Murt2005/TPU/rtl/control/activate-engine.sv

`timescale 1ns / 1ps

import tpu_pkg::*;

// ACT engine: ACC rows -> bias -> ReLU/identity -> optional requantize -> UB, host
// out FIFO or DDR3, plus RD_UB and SET_OBASE. to DDR3 the words the host would get
// go to ddr_writer at OBASE, which advances past them; such an ACTIVATE completes
// once the writer has handed every word to the bus. control only: tpu_core wires the bias and activation
// units. shares the ACC and UB read ports with MM, which has priority there; ACT
// has priority on the UB write port
module activate_engine #(
    parameter int ARRAY_SIZE              = 8,
    parameter int UB_ADDRESS_WIDTH        = 14,
    parameter int ACC_ADDRESS_WIDTH       = 10,
    parameter int PARAMETER_ADDRESS_WIDTH = 8
) (
    input  logic                               clk,
    input  logic                               reset,

    input  logic                               queue_valid_in,
    input  logic [QUEUE_ENTRY_WIDTH-1:0]       queue_entry_in,
    output logic                               queue_pop_out,
    input  logic [63:0]                        completed_in,
    output logic                               instruction_done_out,

    output logic [ACC_ADDRESS_WIDTH-1:0]       ACC_read_address_out,
    input  logic                               ACC_read_blocked_in,        // MM owns the port this cycle

    output logic [PARAMETER_ADDRESS_WIDTH-1:0] parameter_read_address_out, // the bias and quant tables
    output logic                               bias_enable_out,            // bias unit
    output logic                               relu_enable_out,            // activation unit
    input  logic [ARRAY_SIZE*32-1:0]           activation_row_in,          //   biased, ReLU'd: stage 1
    output logic                               multiply_enable_out,        //   stage 2 multiplies row
    output logic [ARRAY_SIZE*32-1:0]           multiply_row_out,
    input  logic [ARRAY_SIZE*8-1:0]            quantized_row_in,           //   stage 3

    output logic                               UB_write_enable_out,
    output logic [UB_ADDRESS_WIDTH-1:0]        UB_write_address_out,
    output logic [ARRAY_SIZE*8-1:0]            UB_write_data_out,

    output logic                               UB_read_enable_out,
    output logic [UB_ADDRESS_WIDTH-1:0]        UB_read_address_out,
    input  logic                               UB_read_blocked_in,
    input  logic [ARRAY_SIZE*8-1:0]            UB_read_data_in,

    output logic                               output_push_out,
    output logic [31:0]                        output_word_out,
    input  logic                               output_full_in,

    output logic                               DDR_word_valid_out,         // ddr_writer
    output logic [31:0]                        DDR_word_address_out,
    input  logic                               DDR_full_in,
    input  logic                               DDR_idle_in,

    output logic                               blocked_out,                // has work it can't advance (profiler)
    output logic                               idle_out
);

    localparam int WORDS_PER_INT8_ROW = ARRAY_SIZE / 4;

    logic [63:0] instruction, wait_snapshot;
    assign instruction   = queue_entry_in[63:0];
    assign wait_snapshot = queue_entry_in[127:64];
    logic [5:0] opcode;
    assign opcode = instruction[63:58];

    typedef enum logic [2:0] {S_IDLE, S_READ, S_LATCH, S_MULTIPLY, S_ROUND, S_EMIT, S_WRITE, S_DRAIN} state_t;
    state_t state;

    logic                     is_read_UB;
    logic                     requantize, destination_is_UB, destination_is_DDR;
    logic [31:0]              output_base;                   // OBASE
    logic [15:0]              UB_destination_address;
    logic [8:0]               activation_rows;
    logic [10:0]              block_count, block_index;
    logic [8:0]               row_in_block;
    logic [15:0]              read_address;                  // ACC row, or UB entry for RD_UB
    logic [15:0]              UB_entries_left;               // RD_UB entries
    logic [7:0]               parameter_index;
    logic [7:0]               word_index;                    // word within the row being emitted
    logic [ARRAY_SIZE*32-1:0] result_row;                    // computed row, one word per column (or packed int8)

    assign ACC_read_address_out       = ACC_ADDRESS_WIDTH'(read_address);
    assign UB_read_address_out        = UB_ADDRESS_WIDTH'(read_address);
    assign parameter_read_address_out = PARAMETER_ADDRESS_WIDTH'(parameter_index);
    assign UB_read_enable_out         = state == S_READ && is_read_UB && !UB_read_blocked_in;
    assign multiply_enable_out        = state == S_MULTIPLY;
    assign multiply_row_out           = result_row;

    logic [7:0] words_to_emit;
    assign words_to_emit = (is_read_UB || requantize) ? 8'(WORDS_PER_INT8_ROW) : 8'(ARRAY_SIZE);

    assign UB_write_enable_out  = state == S_WRITE;
    assign UB_write_address_out = UB_ADDRESS_WIDTH'(UB_destination_address);
    assign UB_write_data_out    = result_row[ARRAY_SIZE*8-1:0];
    assign output_push_out      = state == S_EMIT && !destination_is_DDR && !output_full_in;
    assign output_word_out      = result_row[32*word_index +: 32];
    assign DDR_word_valid_out   = state == S_EMIT && destination_is_DDR && !DDR_full_in;
    assign DDR_word_address_out = output_base;

    logic word_emitted;
    assign word_emitted = output_push_out || DDR_word_valid_out;

    logic wait_satisfied;
    assign wait_satisfied = wait_counts_reached(instruction[51:48], wait_snapshot, completed_in);
    assign queue_pop_out  = queue_valid_in && state == S_IDLE && (opcode != OPCODE_WAIT || wait_satisfied);
    assign idle_out       = state == S_IDLE && !queue_valid_in;
    // a WAIT not yet satisfied, MM holding the ACC or UB read port, a full out FIFO or DDR3 writer
    assign blocked_out    = (queue_valid_in && state == S_IDLE && !queue_pop_out)
                            || (state == S_READ && (is_read_UB ? UB_read_blocked_in : ACC_read_blocked_in))
                            || (state == S_EMIT && !word_emitted) || (state == S_DRAIN && !DDR_idle_in);

    always_ff @(posedge clk) begin
        if (reset) begin
            state                  <= S_IDLE;
            is_read_UB             <= 1'b0;
            relu_enable_out        <= 1'b0;
            bias_enable_out        <= 1'b0;
            activation_rows        <= '0;
            block_count            <= '0;
            block_index            <= '0;
            row_in_block           <= '0;
            read_address           <= '0;
            UB_entries_left        <= '0;
            parameter_index        <= '0;
            word_index             <= '0;
            result_row             <= '0;
            requantize             <= 1'b0;
            destination_is_UB      <= 1'b0;
            destination_is_DDR     <= 1'b0;
            output_base            <= '0;
            UB_destination_address <= '0;
            instruction_done_out   <= 1'b0;
        end else begin
            instruction_done_out <= 1'b0;
            case (state)
                S_IDLE: if (queue_pop_out) begin
                    if (opcode == OPCODE_ACTIVATE) begin
                        is_read_UB             <= 1'b0;
                        requantize             <= instruction[55];
                        destination_is_UB      <= instruction[54:53] == DESTINATION_UB;
                        destination_is_DDR     <= instruction[54:53] == DESTINATION_DDR;
                        UB_destination_address <= 16'(instruction[23:10]);
                        relu_enable_out        <= instruction[57:56] == 2'd1;
                        bias_enable_out        <= instruction[52];
                        block_count            <= 11'(instruction[51:42]) + 11'd1;
                        activation_rows        <= 9'(instruction[41:34]) + 9'd1;
                        read_address           <= 16'(instruction[33:24]);
                        parameter_index        <= instruction[9:2];
                        block_index            <= '0;
                        row_in_block           <= '0;
                        state                  <= S_READ;
                    end else if (opcode == OPCODE_RD_UB) begin
                        is_read_UB        <= 1'b1;
                        requantize        <= 1'b0;
                        destination_is_UB <= 1'b0;
                        destination_is_DDR <= 1'b0;
                        read_address      <= 16'(instruction[45:32]);
                        UB_entries_left   <= 16'(instruction[11:0]) + 16'd1;
                        state             <= S_READ;
                    end else begin
                        if (opcode == OPCODE_SET_OBASE)
                            output_base <= instruction[31:0];
                        instruction_done_out <= 1'b1;            // SET_OBASE, WAIT
                    end
                end
                S_READ: if (is_read_UB ? !UB_read_blocked_in : !ACC_read_blocked_in) state <= S_LATCH;
                S_LATCH: begin                         // read data valid this cycle
                    result_row <= is_read_UB ? (ARRAY_SIZE*32)'(UB_read_data_in) : activation_row_in;
                    word_index <= '0;
                    state      <= requantize ? S_MULTIPLY : destination_is_UB ? S_WRITE : S_EMIT;
                end
                S_MULTIPLY: state <= S_ROUND;                 // the activation unit multiplies row
                S_ROUND: begin
                    result_row <= (ARRAY_SIZE*32)'(quantized_row_in);
                    state      <= destination_is_UB ? S_WRITE : S_EMIT;
                end
                S_WRITE: begin                         // one UB entry per row
                    UB_destination_address <= UB_destination_address + 16'd1;
                    read_address           <= read_address + 16'd1;
                    state                  <= S_READ;
                    if (row_in_block == activation_rows - 9'd1) begin
                        row_in_block    <= '0;
                        parameter_index <= parameter_index + 8'd1;
                        if (block_index == block_count - 11'd1) begin
                            state                <= S_IDLE;
                            instruction_done_out <= 1'b1;
                        end
                        block_index <= block_index + 11'd1;
                    end else begin
                        row_in_block <= row_in_block + 9'd1;
                    end
                end
                S_EMIT: if (word_emitted) begin
                    if (destination_is_DDR)
                        output_base <= output_base + 32'd4;
                    if (word_index == words_to_emit - 8'd1) begin
                        read_address <= read_address + 16'd1;
                        state        <= S_READ;
                        if (is_read_UB) begin
                            UB_entries_left <= UB_entries_left - 16'd1;
                            if (UB_entries_left == 16'd1) begin
                                state                <= S_IDLE;
                                instruction_done_out <= 1'b1;
                            end
                        end else if (row_in_block == activation_rows - 9'd1) begin
                            row_in_block    <= '0;
                            parameter_index <= parameter_index + 8'd1;
                            if (block_index == block_count - 11'd1) begin
                                if (destination_is_DDR) begin
                                    state <= S_DRAIN;
                                end else begin
                                    state                <= S_IDLE;
                                    instruction_done_out <= 1'b1;
                                end
                            end
                            block_index <= block_index + 11'd1;
                        end else begin
                            row_in_block <= row_in_block + 9'd1;
                        end
                    end else begin
                        word_index <= word_index + 8'd1;
                    end
                end
                S_DRAIN: if (DDR_idle_in) begin                // every word is on the bus
                    state                <= S_IDLE;
                    instruction_done_out <= 1'b1;
                end
                default: state <= S_IDLE;
            endcase
        end
    end

endmodule
