Murt2005/TPU/(commit log)

2026-06-19 fixed syntax in mmu and logic in pe
    [mmu.sv, pe.sv]
2026-06-19 fixed syntax in mmu.sv and logic in pe.sv
    [mmu.sv, pe.sv]
2026-06-27 Add weight loader (ROM -> weight_fifo bridge)
    Reads a weight tile from a dual-port weight ROM and pushes it into the
    weight_fifo shadow bank in bottom-row-first order per the staggered
    weight-load contract. Dual read ports fetch a full row per cycle so both
    columns push together; ROM_LATENCY parameter keeps the FSM correct for
    combinational, output-registered, or fully-registered (M10K, 2-cycle) ROMs.
    done pulses one cycle after the final FIFO write so the sequencer can swap
    banks safely.
    Adds self-checking weight_loader_tb (registered 2-cycle ROM model) and
    weight_loader_fifo_tb (ROM -> loader -> weight_fifo -> drain) integration
    test. Wires both into the Makefile and run_tests.sh (15 test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
2026-06-30 added uart rx/tx
2026-07-05 Add pico2-ice (iCE40) build target; fix yosys/iverilog portability issues
    yosys's built-in SystemVerilog frontend can't parse unpacked-array module
    ports (used throughout the datapath for 2-wide buses) or SVA immediate
    assertions with an else clause. Converts those ports to packed 2D arrays
    and rewrites fifo.sv's depth check as a plain if/$fatal, so the design
    now synthesizes for iCE40 as well as Cyclone V.
    The packed-array conversion also surfaced two latent Icarus Verilog 13.0
    quirks: a word-select out of a signed packed 2D array silently drops its
    signedness (activation.sv's ReLU check now uses an explicit $signed()
    cast), and a same-time-step testbench read of a combinational output can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
    [accumulator.sv, activation.sv, bias.sv, fifo.sv]
2026-07-06 Bring up tpu_top on real pico2-ice hardware; add tpu_host.py
    Full datapath now verified end-to-end on real iCE40 silicon, matching
    simulation golden values bit-for-bit.
    Two real bugs found and fixed along the way:
    - tpu_top.sv had no power-on-reset generator. Every module's registers
    (e.g. uart_tx's tx_busy/state) only get a known-good value inside their
    `if (reset)` branch. On this board reset_n reads idle-high the instant
    the FPGA configures (a plain pull-up, no reset IC), so that branch never
    fired even once, leaving registers to whatever the toolchain's power-on
    initial-value inference happened to pick -- uart_tx powered up
    permanently stuck (tx_busy never clear) and never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
2026-07-06 Add pico2-ice bring-up runbook; fix unused-var lint in tpu_host.py
    Documents the full build/flash/validate process end to end, plus the
    real bugs found during hardware bring-up (wrong RP2350 UART pins, the
    DFU false-alarm status message, and the missing power-on-reset that
    left uart_tx stuck) so the next person debugging this doesn't have to
    re-derive it from scratch.
2026-07-07 added pico-ice-sdk as a submodule under firmware/
2026-07-07 Add LED green/blue command listener to RP2040-logs CDC port
2026-07-07 Add multi-layer MNIST inference driver and interactive drawing demo
2026-07-11 added CMD_RUN_TILE
    cut ms/image from ~8000 to ~4000
2026-07-12 raise UART to 1 Mbaud (Tier 1): 2454 -> 316 ms/image on MNIST
    BAUD_RATE is now an fpga/Makefile build knob baked into the bitstream (1 Mbaud = exact /12 of the 12 MHz clock, zero baud error), with tpu_host.py defaulting to match.
2026-07-12 fix TinyUSB race in uart0->CDC bridge: ring buffer instead of ISR writes
    The UART0 RX ISR wrote to TinyUSB concurrently with the main loop's tud_task(), wedging the whole USB stack at 1 Mbaud; the ISR now only fills a ring buffer that the main loop drains.
2026-07-12 scale array to 2x4 (8 PEs, all DSP-backed): 316 -> 240 ms/image on MNIST
    4x4 doesn't fit the UP5K and 2x4 beats 4x2 since wire bytes scale as K*N*M_TILE/NUM_COLS; the shape is now a Makefile build knob, and the host zero-pads any M/K/N so odd shapes just work.
2026-07-12 probe array shape + resync sequencer on connect
    TPU() now flushes any pending frame, resets, and probes the device's synthesis-time shape, so a host/bitstream mismatch fails immediately with a message naming the --rows/--cols/--m-tile fix instead of silently desyncing the sequencer.
2026-07-12 fix all verilator lint warnings in RTL: dead result_ok, width casts, genvar shadowing, generate labels
    [accumulator.sv, fifo.sv]
2026-07-12 add make lint + Verilator C++ full-chip testbench (make verilate-test, 3 shapes over real UART pins)
2026-07-12 add SPI host PHY: spi_slave.sv + USE_SPI build knob + CMD_NOP poll filler, verified in sim (unit TB + full-chip Verilator SPI BFM)
2026-07-12 add TPU_LINK_SPI firmware bridge: CDC<->spi0 with frame-aware response polling, flash deep-power-down on the shared bus
2026-07-13 SPI link bring-up: --link spi host flag (no write pacing, SPI wire accounting), 24 MHz FPGA clock for SPI builds: 239 -> 88 ms/image on MNIST
2026-07-13 add FW_MATMUL bulk command to run the whole tiling loop on the RP2350 (firmware/tpu_tile.c absorbs the SPI bridge), host probe + offload path with --no-offload fallback, offload-vs-local A/B in hw_re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
2026-07-24 extract wire-protocol opcodes/status into rtl/tpu_pkg.sv, imported by the sequencer
2026-07-24 restructure fpga/ into per-board dirs (fpga/ice40) with a board dispatcher; update README paths
2026-07-24 add DE1-SoC HPS transport: extract board-neutral tpu_core, add hps_bridge Avalon-MM PHY + tpu_top_hps + unit tb
2026-07-24 README: expand DE1-SoC future work with the AWS cloud-build infra and on-board bring-up / scale-up next steps
2026-07-30 docs: rewrite as a 10-file set organized around the current architecture
    The old docs/ was a chronological analysis trail: proposals for work that
    shipped weeks ago, headline numbers from the 2x2/UART era, and two array-size
    ceilings that were later retracted. Rewritten around what the design is now
    rather than how it got here, with the measurement history consolidated into
    one dated section of performance.md.
    README.md index + reading order
    architecture.md datapath, board-neutral core vs tops, shape parameters
    protocol.md wire protocol as shipped, all three PHYs, FW_* commands
    pico2-ice.md iCE40 target reference: knobs, gotchas, bisect ladder
    de1soc.md Cyc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
2026-07-30 README: correct the retracted 4x4 ceiling and other claims stale since 07-13
    - The 'largest shape that fits' bullet still said 2x4, and cited the 8-DSP
    ceiling that pe_pair.sv's dual-8x8 SB_MAC16 mode retired. It's 4x4/M_TILE=4
    at 4,935 LCs (93%), hardware-validated 14/14.
    - hw-test validated shapes: add 4x4.
    - Fastest config (§5.1) rebuilt around the 4x4 SPI build; add the
    USE_MAC16_PAIR build knob, which was undocumented.
    - Latency: six steps -> seven (the pe_pair array), 64 -> 63.8 ms.
    - verilate-test covers seven shape/PHY combos, not three.
    - Point at docs/ from the intro, §5.2 and the future-work bullet.
2026-07-30 add CLAUDE.md steering files (root + 4 nested)
    Root: two-chip model and the firmware-first flash order, the make targets,
    the four gotchas that cost the most time (dfu-util's false "firmware
    corrupt", the CLK_FREQ/baud coupling across three files, the post-flash
    replug, the indistinguishable CDC ports), layout, and status pointing at
    README §6 rather than duplicating it. Pulls in docs/ via @imports.
    Nested, so each only loads when work is actually in that directory:
    rtl/ house style, the ARRAY_ROWS/NUM_COLS/M_TILE pattern, and that
    module latency is a contract the sequencer replays exactly
    firmware/ cmake knobs, the vendored SDK submodule and its two worked-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
2026-09-21 pe/mmu: make the partial-sum width a parameter
    pe.sv hard-wired its psum ports to [15:0]. Add PSUM_WIDTH (default 16, so
    every existing build is unchanged) and thread it from mmu.
    The MAC's zero addend becomes a signed localparam rather than a bare '0:
    an unsigned literal there would make the whole addition unsigned and
    silently break sign extension of the product.
    pe_pair is SB_MAC16-backed and its accumulator is a hard 16 bits, so the
    DSP-pair path now $errors unless PSUM_WIDTH=16, alongside the existing
    even-ARRAY_ROWS check.
    [mmu.sv, pe.sv]
2026-09-21 sequencer/core/tops: thread PSUM_WIDTH as a build knob
    Widening the reduction path is a wire-format change, not just a datapath
    one: bias and result elements become PSUM_WIDTH/8 little-endian bytes
    each. Both pack/unpack loops now iterate PSUM_BYTES instead of assuming
    2, and B_BYTES/RESULT_BYTES derive from it.
    Default stays 16, so every existing bitstream, host and test vector is
    byte-identical -- verified with make test (22/22), make lint (4 configs)
    and make verilate-test (7 shape/PHY combos), all unchanged.
    Adds elaboration guards for the constraints a wide build can trip: LEN is
    one byte, so PSUM_BYTES*M_TILE*NUM_COLS must stay under 256. At 32 bits
    that caps M_TILE*NUM_COLS at 63 --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
2026-09-21 activation: make the ReLU clamp bypassable per RUN
    activation.sv applied ReLU unconditionally with no bypass mode, so every
    layer had to be ReLU-terminated. Any network with a linear output
    projection was unrepresentable.
    Adds a `bypass` input, selected per pass by flags[2] of the RUN /
    RUN_TILE / STREAM_RUN flags byte and held stable by the sequencer for the
    whole orchestration sequence, exactly like tile_first/tile_last. Latency
    is unchanged in both modes, so the sequencer's replayed cycle sequence
    does not move.
    The flags-byte bit positions now have names in tpu_pkg alongside the
    opcodes, replacing the bare payload[0][0]/[1] literals at the three
    parse sites.
    Default is 0, so an existi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
2026-09-21 tpu_host: psum_width and act_bypass support
    Mirrors the RTL side. psum_width (default 16) drives the bias/result
    element dtype and result_bytes; act_bypass sets the new flags[2] on RUN,
    RUN_TILE and STREAM_RUN. The flags byte is packed by one _flags() helper
    instead of three copies of the same bit arithmetic, with FLAG_* constants
    mirroring tpu_pkg.
    FW_MATMUL is compiled into the firmware with a 16-bit result element and
    no flags plumbing, so matmul_tiled falls back to the host-tiled path when
    psum_width != 16 or act_bypass is set, and offload=True now raises rather
    than silently returning ReLU'd or wrong-width results.
    The shape-probe mismatch error names psum_width too -- the probe compa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
2026-09-21 verilate-test: cover PSUM_WIDTH=32 and the ReLU bypass
    The C++ bench assumed int16 in four places (RESULT_BYTES, the golden
    model's wrap, the bias pack and the result unpack). All four now derive
    from TB_PSUM_WIDTH, and golden() takes a relu flag so it can model the
    bypass path.
    Three new shapes, selected by a trailing 32 on the PHY field:
    2_2_2_uart32, 4_4_2_spi32, 8_8_4_uart32. The last is the transformer-
    sized one -- M_TILE=4 rather than 8 keeps the result frame at 128 bytes,
    since 8x8/M_TILE=8 at 4 bytes per element would need 256 and blow the
    1-byte LEN cap.
    Three new cases: ACT_BYPASS over bare RUN (asserting negatives actually
    survive, so the test cannot pass vacuously), ACT_BYPASS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
2026-09-21 docs: PSUM_WIDTH build knob and the ReLU bypass flag
    Documents both features and adds PSUM_WIDTH to fpga/ice40/Makefile's
    chparam list so it is a real build knob rather than an RTL-only
    parameter.
    Deliberately does not touch any measured result in performance.md: no
    bitstream has been built at PSUM_WIDTH != 16, so the LC/fMax/latency
    tables still describe exactly what they describe. The docs say so
    explicitly -- the wide path is simulation-only coverage.
    Measured cost of the bypass on the tightest build (4x4/M_TILE=4, SPI,
    MAC16 pair), against a baseline worktree on the same toolchain:
    4958 -> 4999 LCs (93% -> 94%), core fMax 32.30 -> 30.08 MHz. Still
    places, routes and passes at the 24 MH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
2026-09-21 verilate-test: direct byte-stream injection bench
    Adds a third transport alongside the UART and SPI BFMs. TB_DIRECT
    verilates tpu_core rather than tpu_top and drives the sequencer's
    rx_data/rx_valid directly, skipping the bit-level PHY. Same protocol,
    same golden checks, same test list.
    40x fewer cycles per tile at 8x8 (288 vs 11520), which is what makes
    transformer-sized workloads tractable in simulation: the whole suite
    runs in 271k cycles against 11.1M over UART at that shape.
    Two pacing constants, both needed because there is no PHY cadence and
    the sequencer exposes no backpressure:
    STREAM_TILE_GAP covers the pipeline pass the sequencer spends between
    tiles not consuming RX. Model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
2026-09-21 sim link: drive the Verilator model from tpu_host.py
    Adds `--link sim`, a third transport beside uart/spi/hps. The direct
    bench gains a --bridge mode that reads host->FPGA frames on stdin and
    writes responses on stdout; SimLink spawns it and presents the same
    duck-typed serial.Serial surface MmioLink already does. `make sim-bridge`
    builds the binary at any shape.
    Everything above the transport is now shared between simulation and
    silicon: matmul_tiled's zero-padding, K-tiling and STREAM_RUN chaining
    run unchanged, so a model debugged in sim moves to the board by changing
    one flag.
    tests/hw_regression.py gains --link sim and --psum-width, and its golden
    model is no longer hardcoded to int16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
2026-09-21 llm: run TinyStories-1M on the array
    A GPT-Neo forward pass whose six linear layers per block, plus the tied
    lm_head, execute as int8 matmuls on the TPU. Host keeps what the hardware
    has no unit for: embedding lookup, LayerNorm, softmax, GELU, residuals.
    Quantization is post-training with no calibration set. Weights are int8
    with a per-output-channel scale (0.39% worst relative error on this
    checkpoint); activations are quantized dynamically per matmul from their
    own max, which is what removes the calibration requirement. Bias stays
    float and is added after dequantization -- folding it into the
    accumulator would need the activation scale, which only exists at
    runtime.
    Needs PSUM_WIDTH=32: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
2026-09-21 viz: RTL trace harness, extractor, and a validated JS datapath model
    Groundwork for an interactive datapath visualizer. Three pieces, each
    independently checkable.
    trace_tb.cpp verilates tpu_core with --trace and drives one RUN_TILE over
    the real byte protocol, dumping every internal signal and echoing the
    device's result. No RTL changes: a VCD already records more than any
    amount of $display would, and synthesizable code stays clean.
    vcd_to_trace.py samples that VCD once per rising edge into a per-cycle
    JSON timeline -- a frame sequence rather than a change log -- keeping the
    ~120 signals the viewer draws, including every PE's weight_reg, streaming
    activation and partial sum.
    model.mjs i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
2026-09-21 viz: interactive datapath viewer
    An HTML page that runs model.mjs in the browser: type in W, A and bias,
    then scrub or play the clock and watch activations sweep right while
    partial sums fall. Colour encodes the three data roles rather than
    decorating -- violet for the stationary weight, amber for an activation
    in flight, teal for a partial sum -- so the wavefront reads at a glance.
    Published at https://claude.ai/artifact/Sr4fZ6oUw15Ee8fXSCq5dC, with
    model.mjs served alongside it from this same file so the page and the
    repo cannot drift apart.
    The page opens mid-wavefront on a worked example rather than empty, and
    checks the rows the ReLU stage actually emitted against a reference so
    the a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
2026-09-21 Makefile: restore the viz targets to .PHONY after the merge
    Both branches edited the same .PHONY line, and the auto-merge kept only
    sim-bridge -- sim-trace, viz-check and viz-check-all were silently
    dropped, so a stray file of any of those names would have shadowed them.
2026-09-21 docs: utilization analysis and a command-interface design
    Measures what the array actually does with its cycles (7-16% MAC-slot
    utilization) and what the wire actually carries, then works out what
    follows.
    Two findings worth the doc. weight_fifo's ping-pong banks are built and
    tied off in tpu_core, and because the sequencer serializes receive and
    compute it stops consuming RX between tiles -- which is the sole reason
    the SPI write clock is capped at CLK/6. One change lifts both ceilings.
    backlog.md's 'worth ~2ms at most' predates this and misses the coupling.
    And weight residency alone is only 2.7x on MNIST, not the order of
    magnitude it looks like, because padded activations then dominate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
2026-09-29 docs: expand architecture.md into a whole-system reference
    Covers the sequencer FSM, PHYs, numerics, the software stack, and the
    build flow; corrects 2x2-only latencies to R+C+3 and notes the RTL
    capabilities tpu_core leaves unwired. Section refs updated to match.
2026-09-29 docs: bring the rest of the docs in line with the September work
    ReLU bypass, PSUM_WIDTH, the sim link, llm/ and viz/ were missing or
    contradicted across README, CONTRIBUTING, CLAUDE.md files, docs/, and the
    firmware/DE1-SoC READMEs. Also corrects claims that never matched the
    code: --link hps in hw_regression/infer, --timing-breakdown, on-chip
    layer write-back, 3-step testbench registration, widths in tpu_pkg.
    [accumulator.sv]
2026-09-30 remove viz/: the datapath visualizer, its trace harness, and make targets
2026-09-30 remove the CLAUDE.md steering files
2026-09-30 restructure: rtl/{core,peripherals}, boards/<board>/, tests by tier, software/
    Board-specific files (tops, pe_pair, pins, FPGA build, firmware) move
    under boards/pico2-ice and boards/de1soc; rtl/ keeps only what every
    board shares. Tests split into sv/, verilator/, hw/; mnist and llm move
    to software/; the Makefile's rules split into mk/. The fpga/ dispatcher
    is gone. Both bitstreams (2x2 UART, 4x4 SPI pair) rebuild bit-identical.
2026-09-30 host: turn tpu_host.py into the host/tpu package with one golden model
    protocol / links / driver / golden / cli modules, installable via
    requirements.txt. The four copies of the reference numerics
    (hw_regression, train_mnist, llm, selftest) now share tpu.golden, and
    the sys.path edits are gone. tpu_host.py stays as a thin wrapper.
2026-09-30 add make check-protocol: the four copies of the wire constants must agree
    RTL package, host driver, C++ bench, and firmware each define the
    opcodes/flags/status bytes; nothing generated one from another. Runs as
    part of make lint. Adds CMD_NOP to the host copy so it mirrors all of
    tpu_pkg.
2026-09-30 boards/pico2-ice: named build configs (make CONFIG=4x4_spi)
    One .mk per hardware-validated build, loaded by both the FPGA build and
    make hw-test, plus make host-flags / show-config for the matching host
    flags. The bitstream now depends on a stamp of every knob, so switching
    config rebuilds instead of reusing the previous config's tpu_top.bin.
2026-10-01 trim comments to short lowercase decision notes; explanations live in docs/
    Header blocks, restated code and narrative history removed across rtl,
    boards, firmware, host, software, tests and build files; what remains
    marks decisions and low-level traps. Code is unchanged (verified with
    comments stripped, and both reference bitstreams match HEAD). protocol.md
    is now the normative protocol spec, and CONTRIBUTING states the rule.
    [accumulator.sv, activation.sv, bias.sv, fifo.sv, golden.py, mmu.sv]
2026-10-01 isa: encoder, reference model and layout helpers for the instruction-stream core
    Phase 1 groundwork from the DE1-SoC instruction stream spec. One field
    table drives encode/decode/reserved-bit checks and reproduces all 16
    encodings in the spec's worked MNIST program. The model executes
    programs in order with 32-bit wrap and the decode errors; it matches
    tpu.golden on random layers and hw_layer on MNIST layer 1.
    [isa.py, isa_layout.py, isa_model.py]
2026-10-01 isa: phase 2 - requantizer and on-chip layer chaining
    ACT requantizes (27-bit pre-saturation, 24-bit M0, round half up, int8
    clamp) and writes the UB, with priority over LD on the write port.
    compile_mlp emits the spec's load/infer programs. Verified: 1.06M inputs
    per (M0, shift) table incl. per-channel match the model; the full
    two-layer MNIST program runs on chip, RTL == model word for word, argmax
    == the host path on 20 images at m=1 and m=8.
2026-10-01 isa: phase 3 - overlapped tiles, verified in Verilator sim
    new isa_pe (w_cur/w_next, flipped by the tile's first activation) and
    isa_array with a per-column skewed row-select weight bus; WT gets a
    two-slot tile buffer that refills a slot the cycle MM releases it; MM
    streams one tile per max(m, N) cycles while loading the next tile's
    weights. isa_waits models per-engine read/write sets and inserts WAITs.
    sim only, no board: RTL == model on 400 random concurrent programs at
    N=8 and N=4 (39/40 diverge without their WAITs), PE invariants never
    fire, T extra tiles cost exactly T*max(m, N) cycles with no extra
    WSTALL at m=1, m=N, m>N. make lint and make test green.
    [isa_compile.py, isa_mm.sv, isa_waits.py, isa_wt.sv]
2026-10-01 de1soc: FPGA-only self-test for the instruction-stream core
    isa_replay plays a ROM register transcript (every expected word from the
    reference model) into tpu_isa_top and reports on LEDR/HEX, so the
    netlist can be checked with no HPS, Linux or SD card. Standalone
    Quartus project with pins cross-checked against a published DE1-SoC
    qsf. IsaModel.run now returns only the words a run produced, as a host
    draining the out FIFO sees them.
    Verilator sim only: PASS at N=8 and N=4; an injected wrong word fails
    with the right mark and count; an empty ROM fails instead of hanging.
    Not yet compiled in Quartus or run on the board.
    [isa_model.py, isa_replay.sv, tpu_isa_selftest.sv]
2026-10-01 de1soc: instruction-stream core passes its self-test on the board
    first hardware result for rtl/isa. fixes the Quartus build needed:
    - multiplies at their real widths: the requantizer was 64x64 per lane
    and the tile/range products 32/64-bit, 120 DSPs on an 87-DSP part; now 78
    - requantizer pipelined over three ACT states: in one cycle it missed
    50 MHz by 4 ns; now Fmax 57.9 MHz in the slow corner
    - single-threaded Quartus: its parallel helpers deadlock under Rosetta
    hardware: self-test PASS on the DE1-SoC (N=8, 50 MHz). sim: isa-test
    (265K requant inputs per table), self-test sim, make lint, make test green.
    [isa_act.sv, isa_dispatch.sv, isa_mm.sv, isa_wt.sv]
2026-10-01 gitignore: quartus pin model dump
2026-10-01 de1soc: perf counters on the self-test, tile rate checked on the board
    isa_replay gets CAP (register -> one of 32 slots) and CHECK (bound a
    slot or a difference, on chip); SW9 + SW4..0 show a slot on HEX5..0.
    the ROM runs 8 vs 16 tiles at m=1, 8, 19 and requires exactly
    8*max(m, 8) extra cycles with no extra WSTALL, and captures the MNIST run.
    hardware: PASS on the DE1-SoC, and every captured slot read off the
    displays equals the Verilator run.
2026-10-01 de1soc: TPU on the HPS bridge, full test suite passes on the board
    tpu_isa_top as a Platform Designer component in Terasic's rev H GHRD at
    0xFF200000 (h2f_lw, clk_0); the Makefile extracts the GHRD from the CD
    and applies the edit, so only our files are tracked. isa_mmio is an ARM
    /dev/mem register server speaking tb_isa's protocol; IsaSerialLink runs
    it over the HPS console, so test_isa_rtl.py drives the board unchanged.
    hardware: U-Boot loads the bitstream from SD, timing met at 50 MHz,
    and every functional test passes on the board: decode errors, 40 random
    layers, MNIST layer 1 and the chained two-layer program, requantizer
    sweeps, 40 random concurrent programs. the cycle-rate check now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
    [isa_device.py]
2026-10-01 de1soc: MNIST end to end on the ARM + TPU, drawing demo on the HEX displays
    mnist_tpu runs on the HPS: raw pixels -> downsample/quantize (bit-exact
    with numpy) -> both layers on the TPU over the lightweight bridge ->
    argmax. bench mode covers the test set; serve mode backs
    draw_demo.py --de1soc, which shows the digit on HEX0 through a new
    hex_pio (0xFF210100) decoded by top/hex_display.sv. the same C builds
    with -DSIM against Verilator. BoardConsole is the shared console launcher.
    hardware, 10,000 test images: 97.50%, 10,000/10,000 equal to the
    reference model; 109.5 us/image end to end at m=1, 77.6 us at m=8.
2026-10-01 de1soc: drawing demo over the console at 1.5625 Mbaud; upload without the SD card
    draw_demo.py --de1soc PORT --baud 1562500: mnist_tpu serve switches the
    HPS console for the session via termios2/BOTHER and restores 115200 on
    exit. 1562500 = 6.25 MHz / 4 is the fastest rate the HPS UART and the
    CP2105 both produce (2083333 doesn't link; busybox stty stops at 921600,
    hence setbaud, a 636-byte libc-free helper). BoardConsole gains stuck-
    console recovery and upload(): raw tty + dd bs=1, md5-checked .part.
    hardware: 10/10 test images correct at both rates; round trip from the
    Mac 73.5 ms -> 7.5 ms, 117 us on the board; 379 KB upload md5-verified.
    [isa_device.py, setbaud.c]
2026-10-01 docs: bring every README and doc up to the DE1-SoC state
    new docs/isa.md: the instruction-stream core's reference (ISA and
    fields, engines, WAIT/SIGNAL, decode errors, layouts, the isa_bridge
    register map, requantizer, overlap, compiler, verification). rewritten:
    docs/de1soc.md (what runs on the board, rev H, the OrbStack Quartus
    toolchain, both build flows, the gotchas), the root README (DE1-SoC
    quick start first; pico2-ice kept as §2), the docs index, verification,
    performance (DE1-SoC numbers), backlog, repo map, the DE1-SoC FPGA
    README. the legacy pages say which core they describe. fixes a stale
    ./llm/fetch.sh path; hps make all also builds setbaud.
2026-10-01 core: move the instruction-stream core into rtl/core, on the TPUv1 datapath files
    rtl/isa/ is gone. its datapath now lives in the original module files,
    rewritten for the new ISA: pe (w_cur/w_next + flip), mmu (row-select
    weight bus), weight_fifo (the two-slot tile buffer), accumulator (column
    de-skew, row tags, the ACC memory and its read-modify-write), bias,
    activation (ReLU + the 3-stage requantizer), unified_buffer, with
    fifo and systolic_data_setup unchanged. tpu_core wires them around the
    control: dispatch + ld/wt/mm/act_engine. isa_ prefix dropped: tpu_pkg,
    host_bridge, tpu_top, tpu_selftest, replay; the Quartus projects follow.
    legacy pieces this makes unbuildable go with it: tpu_se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
    [accumulator.sv, activation.sv, bias.sv, dispatch.sv, mmu.sv, pe.sv, replay.sv]
2026-10-01 tests: unit benches for the rewritten core modules
    plain SystemVerilog, run by verilator --binary (make unit, make
    unit-<name>): a shared check.svh gives named tests, checks that report
    file:line, and a summary whose exit status fails make. one bench per
    datapath module: fifo, systolic_data_setup, pe (flip semantics, writes
    in the flip's cycle, extremes), mmu (three back-to-back tiles on
    mm_engine's overlap schedule at m = 1, N, 2N+1 vs a plain matmul),
    weight_fifo (ping-pong, same-cycle refill), accumulator (skewed rows,
    overwrite/accumulate RMW, wrap, the same row N rows later), bias,
    activation (ReLU; the requantizer against 21,240 vectors from
    tpu.golden.requant), unified_buffer (port pr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
    [gen_requant.py]
2026-10-01 de1soc: moved core re-validated on the board; pace console uploads
    both designs rebuilt from the moved rtl/core and run on the DE1-SoC:
    - self-test: timing met (3.1 ns slack), 351/397 RAM, 78/87 DSPs, 7,587
    ALMs (6,635 before: synthesis is identical, the fitter packs the new
    hierarchy differently); PASS on the board, perf captures equal to the
    pre-move ones
    - GHRD + TPU: 9,637 ALMs, 339/397 RAM, 78 DSPs, 3.4 ns slack; the full
    test_isa_rtl.py suite passes from the ARM (30 checks); MNIST bench:
    97.50%, 10,000/10,000 equal to the reference model, 113.3 us/image
    (m=1) / 80.4 (m=8), ~4% off the earlier run on the ARM side alone
    (preprocessing, untouched by the move, moved by the sa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
2026-10-02 retire the pico2-ice and the legacy byte-protocol core
    tagged pico2-ice-final (58fe354) first: the last commit where the
    pico2-ice and the legacy core build and run (hardware-validated at 2x2,
    2x4, 4x4), with the bring-up guide.
    removed: boards/pico2-ice (gateware, configs, RP2350 firmware, the
    pico-ice-sdk submodule), the UART/SPI/HPS-bridge peripherals, the
    legacy DE1-SoC Quartus scaffold, the Icarus benches and run_tests.sh,
    hw_regression.py and make hw-test, the legacy host driver (protocol,
    links, driver, cli; tpu_host.py and the tpu-host command), software/llm,
    and infer.py's pico2-ice paths.
    kept and moved: the offline MNIST reference (load_model, quantize,
    predict_batch_offline) in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
2026-10-02 docs: rewrite for one core on the DE1-SoC
    architecture.md is now the hardware reference for the core in rtl/core:
    control vs datapath, every module and its latency, memories and port
    priorities, overlapped tiles, the requantizer, parameters, the board
    wrapper. isa.md is the programmer's reference (instructions, registers,
    layouts). rewritten: verification (unit -> model -> RTL -> self-test ->
    board), repo-map, mnist, backlog, de1soc (current build numbers, paced
    uploads), the root README (DE1-SoC only; the first core as history),
    CONTRIBUTING (make check, adding a unit bench), the board READMEs.
    protocol.md and pico2-ice.md removed; performance.md and utilization.md
    keep the pico2-ice number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
2026-10-02 pe: _in/_out ports, weight_flip, partial_sum_valid_in
    first_in/out becomes weight_flip_in/out (renamed down the chain from
    matmul_engine), weight_data/weight_select become weight_in/weight_valid_in,
    and the partial sum from above now carries its valid. The output valid
    needs both; a sim check fires on an activation without a valid partial sum.
2026-10-02 fifo: _in/_out ports; power-of-2 depth as an SVA assert
    Verilator builds now pass --assert so the check still runs. Rename only:
    captures and quartus_map unchanged.
2026-10-02 rtl: _in/_out ports on the engines, dispatch, tpu_core and host_bridge
    clk, reset and avs_* keep their standard names. host_bridge's register
    constants one per line. Rename only: captures and quartus_map unchanged.
    [dispatch.sv]
2026-10-02 rtl: clearer local names
    Vague or near-colliding locals spelled out (k_tile_index, result_row,
    WORDS_PER_INT8_ROW, ...); tpu_core locals no longer end in _in. Rename
    only: captures and quartus_map unchanged.
    [accumulator.sv, activation.sv, dispatch.sv]
2026-10-02 uvm: phase 1, Verilator 5.052 and the fifo environment
    uvm-verilator (UVM 2020-3.2) as a pinned submodule, make uvm in make check,
    hand-counted coverage bins, and fifo_random_test (mutation-checked).
    5.052 also needed PROCASSINIT waivers for the board tops' power-up values
    and caught a static initializer in the systolic-data-setup bench.
2026-10-02 uvm: phase 3, tpu_top through its Avalon slave
    gen_cases.py writes every case's words from the reference model; the UVM
    sequence replays them with random bus timing (interleaved pushes, gaps,
    OUT drained mid-run, a waitrequest stall). 107 cases at N = 8, 103 at
    N = 4, mutation-checked, in make test. Verilator builds capped at JOBS=4.
    [gen_cases.py, tpu-top-if.sv, tpu-top-pkg.sv, uvm-tpu-top.sv]
2026-10-02 selftest: an N=4 sim no longer overwrites the board's ROM
    selftest-rom wrote the board's isa_selftest.hex at whatever N was given,
    so make selftest-sim N=4 put an N=4 transcript into the next bitstream
    (the board timed out in test 01). Other sizes now get their own ROM in
    sim/. Rebuilt with the N=8 ROM: self-test PASS on the board, captures
    equal to Verilator.
2026-10-02 de1soc: DDR3 bandwidth probe on a 128-bit FPGA-to-SDRAM port, 800 MB/s on the board
2026-10-02 de1soc: MATMUL wsrc=1 passes the full suite on the board
2026-10-02 de1soc: every DDR3 instruction passes the full suite on the board
2026-10-02 de1soc: ddr-bench.py; weights stream from DDR3 at the array's full rate on the board
2026-10-03 qwen: phase 4, the host runtime in C; exact against the simulated core, 50 ms a token on the ARM
2026-10-03 qwen chat: end a reply at the model's next turn and stop the board there; conversation preamble
2026-10-03 qwen chat: LED9 blinks as each token goes out
2026-10-03 viz: cycle-by-cycle page of any workload from a traced Verilator model
    tb_isa built with -DTB_TRACE (make viz-sim) writes a VCD sampled before each
    rising edge; tpu/trace.py turns it into one record per cycle; tpu/viz.py runs a
    workload, checks it against the model and renders tpu/viz_template.html.
    software/viz/visualize.py: mlp, matmul, mnist with --visualize-internals; a
    serial: link runs on the board, then replays in sim for the picture. make viz.
2026-10-03 viz: perf counters per phase, board and sim side by side; MM beats must match
    tested on the DE1-SoC: MNIST x8 over the console, outputs and MM beats equal to
    the traced Verilator replay
2026-10-03 profile page: WAITs as outlined boxes, stalls inside an instruction stay filled
2026-10-03 board: profiler on the DE1-SoC; BoardConsole.download over hexdump; Qwen profiled on hardware
    the GHRD build with the profiler (19-bit counters) passes timing (setup +3.2 ns)
    and the full suite on the board (50 checks, WAITs from timestamps == PERF_MM_SYNC
    at 14.4M cycles). qwen-run --profile on the board: 485 programs, nothing dropped,
    1.37 s/token unchanged
2026-10-03 two weight rows per cycle (WEIGHT_LANES=2): a tile every max(m, N/2) cycles
    each tile's weights stream into the PEs over N cycles, row r at offset r, in step
    with the activation wavefront; with windows shorter than N those streams overlap,
    each on its own lane of the mmu's weight bus. the weight FIFO is a ring of
    lanes+1 slots filled lanes rows a cycle (one 128-bit beat from DDR3, one word of a
    banked WMEM). LANES=1 reproduces the old timing exactly. BUILD register (14) =
    {lanes, N}. small FIFOs in MLABs, weight delays kept out of RAM shift registers.
    resources.py: where a fit report's DSP blocks, RAM and logic go.
    Verilator: rtl-test N=4/8 (LANES=1 and 2), self-test, UVM blocks + tpu_top N=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
    [fifo.sv, host-bridge.sv, isa_device.py, matmul-engine.sv, mmu.sv, profiler.sv]
2026-10-03 256-bit DDR3 option: DDR_BEAT_BITS through the core, four weight lanes, a tile every 2 cycles
    the beat width is a parameter of ddr_reader, ddr_writer, memory_arbiter and the
    LD/WT engines; tb_isa's DDR3 model follows TB_BEAT_BYTES. the GHRD flow takes
    DDR_BITS (default 256): the HPS port width, the TPU's lanes and beat, the probe's
    master, and u-boot.scr's FIFO port release (0x133 or 0x1FF). ddr_probe reports its
    beat; BUILD = {beat bytes, lanes, N}; profile files v2 carry the lanes.
    Verilator: rtl-test N=8 LANES=4 BEAT=32 (m=1: 2 cycles a tile, from DDR3 too),
    128-bit N=8/4 and self-test unchanged; Qwen 291 matmuls exact, 309 ms of MM a token
2026-10-03 GHRD width through qsys-script --cmd (its Tcl shell doesn't see the environment); Quartus can't parse ~ on a size cast
    components take their DDR3 widths from parameters that add-tpu.tcl sets; docs for
    the weight streams and BUILD. two lanes on the DE1-SoC: the full suite passes
    (DDR3 streaming adds 0 stall cycles per tile at m=1), Qwen 0.75 s/token (was
    1.37): MM 618 ms at 4.001 cycles a tile, the ARM's gaps 122 ms
    [ddr-probe.sv, load-engine.sv]
2026-10-03 viz: weight lanes and lanes+1 tile slots; chat.py quits qwen-run on SIGTERM too
    the trace keeps every lane of the weight bus, MM's per-lane stream (slot, row) and
    the wider slot indices; the page sizes the tile buffer to its slots, stacks each
    column's lane chips, takes tile identities from stream starts. chat.py stopped
    from outside left qwen-run --serve holding a raw console
